Jangmyun/IoT_LoRa_PubSub_Rescue_System/detection_ml_v1/test/csv_result_001.csv

timestamp_ms | buoy_id | sonar_cm | accel_mag_ms2 | sonar_valid | sonar_timeout | label
1781516877224 | 2 | 60 | 11.0 | 1 | 0
1781516879137 | 1 | 56 | 11.5 | 1 | 0
1781516880315 | 2 | 63 | 10.9 | 1 | 0
1781516883416 | 2 | 31 | 10.9 | 1 | 0
1781516885319 | 1 | 36 | 11.6 | 1 | 0
1781516886483 | 2 | 24 | 11.0 | 1 | 0
1781516888399 | 1 | 32 | 11.7 | 1 | 0
1781516889541 | 2 | 20 | 11.0 | 1 | 0
1781516891519 | 1 | 89 | 11.6 | 1 | 0
1781516892589 | 2 | 20 | 10.9 | 1 | 0
1781516894554 | 1 | 86 | 11.6 | 1 | 0
1781516895645 | 2 | 20 | 11.0 | 1 | 0
1781516897707 | 1 | 83 | 11.7 | 1 | 0
1781516898731 | 2 | 21 | 10.9 | 1 | 0
1781516900847 | 1 | 84 | 11.6 | 1 | 0
1781516903912 | 1 | 255 | 11.6 | 1 | 0
1781516905035 | 2 | 20 | 11.0 | 1 | 0
1781516907014 | 1 | 23 | 11.6 | 1 | 0
1781516907936 | 2 | 20 | 11.1 | 1 | 0
1781516910063 | 1 | 23 | 11.5 | 1 | 0
1781516910989 | 2 | 20 | 11.0 | 1 | 0
1781516913123 | 1 | 22 | 11.6 | 1 | 0
1781516914052 | 2 | 20 | 11.0 | 1 | 0
1781516916176 | 1 | 22 | 11.6 | 1 | 0
1781516917108 | 2 | 20 | 11.0 | 1 | 0
1781516919230 | 1 | 22 | 11.6 | 1 | 0
1781516920525 | 2 | 20 | 11.0 | 1 | 0
1781516922313 | 1 | 22 | 11.6 | 1 | 0
1781516923672 | 2 | 20 | 11.0 | 1 | 0
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
