Jangmyun/IoT_LoRa_PubSub_Rescue_System/detection_ml_v1/test/csv_result_002.csv

timestamp_ms | buoy_id | sonar_cm | accel_mag_ms2 | sonar_valid | sonar_timeout | label
1781517057866 | 1 | 20 | 9.4 | 1 | 0
1781517060074 | 2 | 56 | 11.5 | 1 | 0
1781517061756 | 1 | 20 | 11.6 | 1 | 0
1781517063495 | 2 | 226 | 11.1 | 1 | 0
1781517065116 | 1 | 24 | 10.0 | 1 | 0
1781517066651 | 2 | 184 | 8.9 | 1 | 0
1781517068195 | 1 | 124 | 12.8 | 1 | 0
1781517069833 | 2 | 113 | 10.7 | 1 | 0
1781517071462 | 1 | 67 | 10.6 | 1 | 0
1781517073244 | 2 | 126 | 11.8 | 1 | 0
1781517074971 | 1 | 126 | 11.9 | 1 | 0
1781517076584 | 2 | 42 | 11.7 | 1 | 0
1781517078333 | 1 | 118 | 12.1 | 1 | 0
1781517080006 | 2 | 34 | 10.4 | 1 | 0
1781517081653 | 1 | 155 | 11.1 | 1 | 0
1781517083326 | 2 | 40 | 10.0 | 1 | 0
1781517085028 | 1 | 153 | 11.4 | 1 | 0
1781517086784 | 1 | 20 | 10.3 | 1 | 0
1781517088474 | 2 | 124 | 12.6 | 1 | 0
1781517090068 | 2 | 118 | 11.1 | 1 | 0
1781517091703 | 2 | 123 | 10.8 | 1 | 0
1781517093412 | 1 | 24 | 11.5 | 1 | 0
1781517095114 | 2 | 126 | 9.9 | 1 | 0
1781517096839 | 1 | 51 | 11.1 | 1 | 0
1781517098708 | 2 | 118 | 10.4 | 1 | 0
1781517100392 | 1 | 21 | 11.2 | 1 | 0
1781517102121 | 2 | 120 | 10.7 | 1 | 0
1781517103901 | 1 | 30 | 11.8 | 1 | 0
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
