Jangmyun/IoT_LoRa_PubSub_Rescue_System/detection_ml_v1/test/csv_result_004.csv

timestamp_ms | buoy_id | sonar_cm | accel_mag_ms2 | sonar_valid | sonar_timeout | label
1781517398385 | 1 | 20 | 11.2 | 1 | 0
1781517401382 | 1 | 30 | 11.3 | 1 | 0
1781517404432 | 1 | 122 | 11.1 | 1 | 0
1781517405460 | 2 | 56 | 14.3 | 1 | 0
1781517407532 | 1 | 158 | 10.6 | 1 | 0
1781517408594 | 2 | 150 | 13.1 | 1 | 0
1781517410610 | 1 | 119 | 13.4 | 1 | 0
1781517411764 | 2 | 22 | 9.6 | 1 | 0
1781517413760 | 1 | 33 | 12.6 | 1 | 0
1781517414895 | 2 | 40 | 12.8 | 1 | 0
1781517416864 | 1 | 122 | 10.9 | 1 | 0
1781517417976 | 2 | 26 | 13.4 | 1 | 0
1781517420018 | 1 | 69 | 13.1 | 1 | 0
1781517421124 | 2 | 20 | 11.7 | 1 | 0
1781517423066 | 1 | 45 | 12.4 | 1 | 0
1781517424259 | 2 | 28 | 10.7 | 1 | 0
1781517426156 | 1 | 109 | 11.8 | 1 | 0
1781517427333 | 2 | 28 | 11.6 | 1 | 0
1781517429255 | 1 | 73 | 13.8 | 1 | 0
1781517430457 | 2 | 40 | 14.4 | 1 | 0
1781517432333 | 1 | 90 | 12.2 | 1 | 0
1781517433551 | 2 | 255 | 6.7 | 1 | 0
1781517435431 | 1 | 255 | 10.8 | 1 | 0
1781517436634 | 2 | 64 | 7.3 | 1 | 0
1781517438497 | 1 | 20 | 11.0 | 1 | 0
1781517439916 | 2 | 58 | 12.6 | 1 | 0
1781517441631 | 1 | 69 | 12.2 | 1 | 0
1781517443204 | 2 | 48 | 9.3 | 1 | 0
1781517444713 | 1 | 49 | 12.2 | 1 | 0
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
