Jangmyun/IoT_LoRa_PubSub_Rescue_System/detection_ml_v1/tests/csv_result_002_idle.csv

timestamp_ms | buoy_id | sonar_cm | accel_mag_ms2 | sonar_valid | sonar_timeout | label
1781422332278 | 1 | 20 | 11.4 | 1 | 0 | CALM
1781422333188 | 2 | 20 | 10.8 | 1 | 0 | CALM
1781422335329 | 1 | 20 | 11.4 | 1 | 0 | CALM
1781422338386 | 1 | 20 | 11.3 | 1 | 0 | CALM
1781422339341 | 2 | 20 | 10.9 | 1 | 0 | CALM
1781422341434 | 1 | 20 | 11.5 | 1 | 0 | CALM
1781422342408 | 2 | 202 | 10.8 | 1 | 0 | CALM
1781422344488 | 1 | 20 | 11.4 | 1 | 0 | CALM
1781422345565 | 2 | 156 | 11.0 | 1 | 0 | CALM
1781422347544 | 1 | 20 | 11.5 | 1 | 0 | CALM
1781422348685 | 2 | 101 | 10.9 | 1 | 0 | CALM
1781422350637 | 1 | 20 | 11.4 | 1 | 0 | CALM
1781422351742 | 2 | 98 | 10.9 | 1 | 0 | CALM
1781422353717 | 1 | 20 | 11.3 | 1 | 0 | CALM
1781422354832 | 2 | 100 | 10.9 | 1 | 0 | CALM
1781422356818 | 1 | 20 | 11.4 | 1 | 0 | CALM
1781422357894 | 2 | 98 | 10.9 | 1 | 0 | CALM
1781422359879 | 1 | 20 | 11.5 | 1 | 0 | CALM
1781422360952 | 2 | 103 | 10.9 | 1 | 0 | CALM
1781422362941 | 1 | 20 | 11.3 | 1 | 0 | CALM
1781422364001 | 2 | 96 | 10.9 | 1 | 0 | CALM
1781422366019 | 1 | 20 | 11.3 | 1 | 0 | CALM
1781422367118 | 2 | 154 | 10.9 | 1 | 0 | CALM
1781422369116 | 1 | 20 | 11.4 | 1 | 0 | CALM
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
