Jangmyun/IoT_LoRa_PubSub_Rescue_System/detection_ml_v1/tests/csv_result_003_wave.csv

timestamp_ms | buoy_id | sonar_cm | accel_mag_ms2 | sonar_valid | sonar_timeout | label
1781422558638 | 2 | 56 | 11.4 | 1 | 0 | ENVIRONMENTAL_WAVE
1781422559076 | 1 | 20 | 10.4 | 1 | 0 | ENVIRONMENTAL_WAVE
1781422561774 | 2 | 52 | 9.5 | 1 | 0 | ENVIRONMENTAL_WAVE
1781422562097 | 1 | 20 | 9.3 | 1 | 0 | ENVIRONMENTAL_WAVE
1781422564882 | 2 | 48 | 12.0 | 1 | 0 | ENVIRONMENTAL_WAVE
1781422565151 | 1 | 20 | 11.0 | 1 | 0 | ENVIRONMENTAL_WAVE
1781422567960 | 2 | 49 | 12.5 | 1 | 0 | ENVIRONMENTAL_WAVE
1781422568243 | 1 | 20 | 12.2 | 1 | 0 | ENVIRONMENTAL_WAVE
1781422570959 | 2 | 44 | 12.0 | 1 | 0 | ENVIRONMENTAL_WAVE
1781422571305 | 1 | 20 | 10.7 | 1 | 0 | ENVIRONMENTAL_WAVE
1781422574062 | 2 | 46 | 10.6 | 1 | 0 | ENVIRONMENTAL_WAVE
1781422574392 | 1 | 20 | 10.7 | 1 | 0 | ENVIRONMENTAL_WAVE
1781422577137 | 2 | 123 | 11.7 | 1 | 0 | ENVIRONMENTAL_WAVE
1781422577457 | 1 | 20 | 10.7 | 1 | 0 | ENVIRONMENTAL_WAVE
1781422580285 | 2 | 33 | 10.0 | 1 | 0 | ENVIRONMENTAL_WAVE
1781422580510 | 1 | 20 | 11.2 | 1 | 0 | ENVIRONMENTAL_WAVE
1781422583378 | 2 | 27 | 12.6 | 1 | 0 | ENVIRONMENTAL_WAVE
1781422583594 | 1 | 20 | 9.9 | 1 | 0 | ENVIRONMENTAL_WAVE
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
