Jangmyun/IoT_LoRa_PubSub_Rescue_System/detection_ml_v1/artifacts/test_set_eval_v1/03_per_class_precision_recall_f1.png

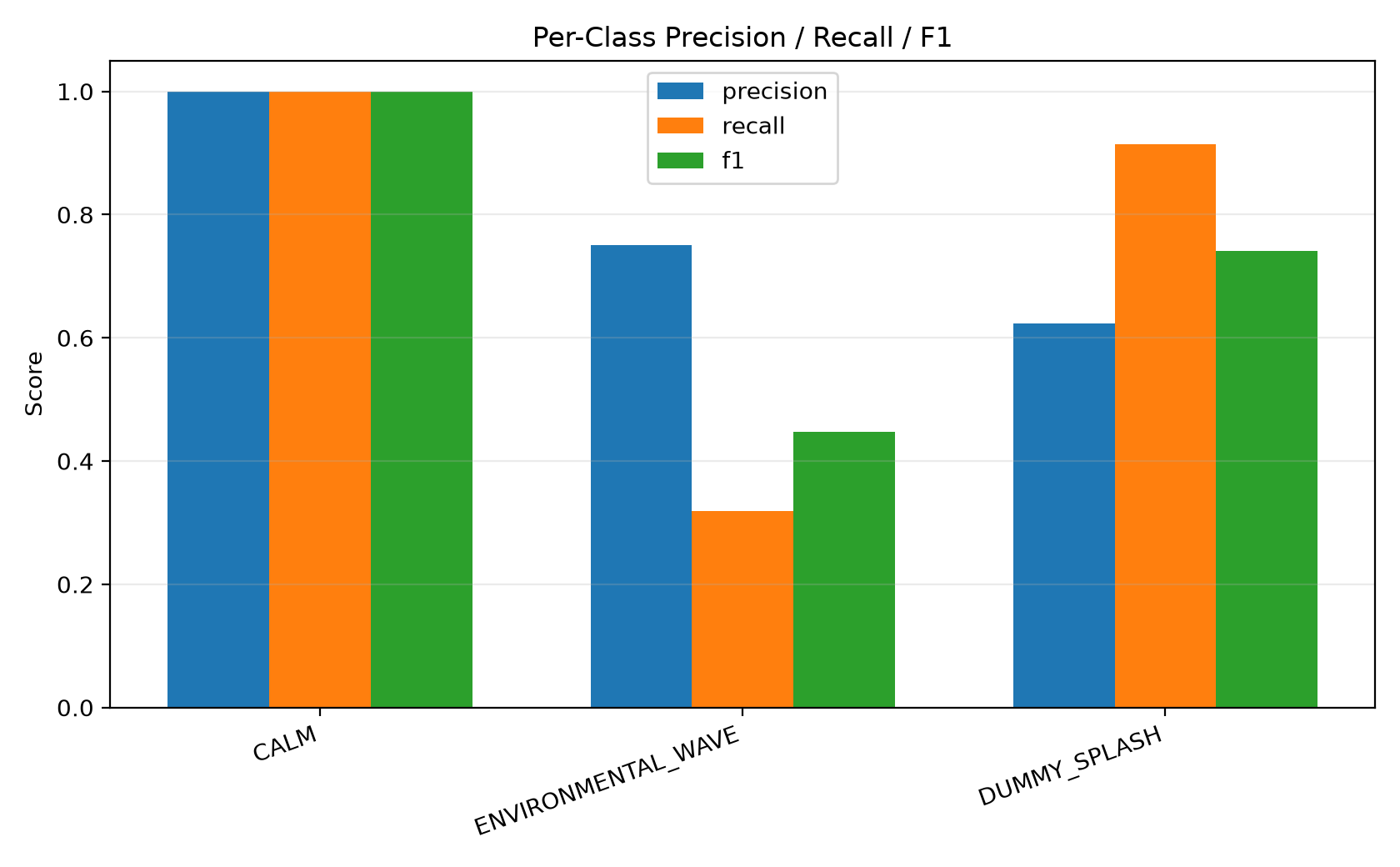
detection_ml_v1/artifacts/test_set_eval_v1/03_per_class_precision_recall_f1.png
