Jangmyun/IoT_LoRa_PubSub_Rescue_System/detection_ml_v1/artifacts/test_set_eval_v1/05_prediction_counts_by_source.png

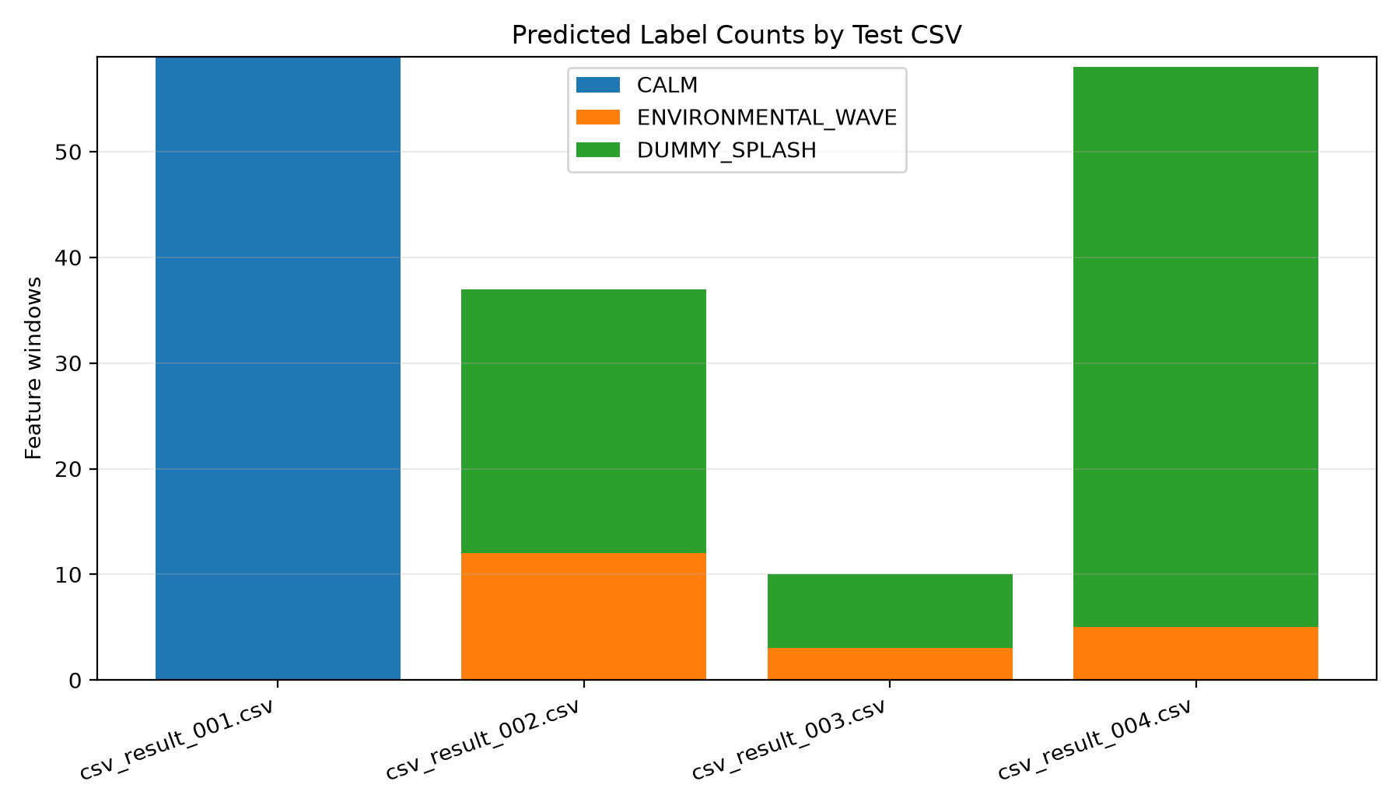
detection_ml_v1/artifacts/test_set_eval_v1/05_prediction_counts_by_source.png
