Jangmyun/IoT_LoRa_PubSub_Rescue_System/(commit log)

2026-06-09 add: arduino.json
2026-06-09 PlatformIO test용 프로젝트
2026-06-09 feat: lora packet format 및 relate method 정의
2026-06-09 feat: mock 기반 테스트용 세팅 추가 (ini)
2026-06-09 LoRaPubSub 테스트 코드
2026-06-09 native 테스트 시 유닛테스트 실행하도록 설정
2026-06-09 프로젝트 빌드 시 native까지 포함되는 문제 해결
2026-06-09 wokwi 시뮬레이션을 위해 esp32에 hc-sr04와 mpu-6050 센서 diagram 추가
2026-06-09 PRD 업데이트
2026-06-09 add: ISensor 순수 추상 인터페이스
    센서 플러그인 구조의 기반이 되는 ISensor 인터페이스 정의.
    begin / read / getValue / getPacked 4개 메서드를 강제하여
    다른 센서 구현체들이 공통 계약을 따르도록 한다.
2026-06-09 add: SonarSensor — HC-SR04 초음파 센서 드라이버
    pulseIn() 기반으로 TRIG/ECHO GPIO를 직접 제어.
    타임아웃 30ms(약 5m) 초과 시 read() false 반환.
    getPacked()는 0-255 cm 클램프 후 1바이트 반환 (LoRa payload용).
2026-06-09 add: ImuSensor — MPU-6050 가속도 센서 드라이버
    Adafruit MPU6050 라이브러리 기반. 3축 가속도의 크기(magnitude)를
    m/s²로 반환하며, getPacked()에서 ×10 후 0-255로 양자화.
    begin() 실패 시 false 반환하여 센서 없는 환경에서도 매니저가 동작 가능.
2026-06-09 add: SensorManager — ISensor 배열 관리 및 LoRa 발행
    attach()로 ISensor* 최대 4개를 동적으로 등록.
    readAll() 후 publishRaw()가 등록 순서대로 getPacked() 값을
    TOPIC_SENSOR_RAW payload로 조립하여 LoRaPubSub으로 발행.
    새 센서 추가 시 ISensor 구현 후 attach() 한 줄로 확장 가능.
2026-06-09 chore: sensor default attr 변경
2026-06-09 dependency 추가: mpu-6050
2026-06-09 sensor example main.cpp
2026-06-09 simulation 속도 조절
2026-06-10 remove: arduino ide based project deleted
2026-06-10 fix: directory name fixed
    [main.cpp]
2026-06-10 구 PlatformIO 폴더 제거
2026-06-10 feat: RPi4 를 위한 LoRa Gateway Server
2026-06-10 fix: wokwi status sensor send
2026-06-10 feat: RPI4 gateway-server 구조 및 연동 구현
    - gateway/lib/packet.py: LoRaPubSub.h 패킷 구조 Python 매핑 (LoRaPublish, LoRaAck, CRC-8)
    - gateway/serial_reader.py: /dev/ttyACM0 시리얼 읽기 및 패킷 파싱 (preamble 스캔, 재연결)
    - gateway/broker.py: 토픽 기반 pub/sub 디스패처 (카테고리 와일드카드, subscribe_all)
    - gateway/main.py: serial_reader + broker 연결, httpx로 server에 패킷 포워딩
    - server/main.py: topic 기반 status 판정 수정 (ALERT=0x10, CLEAR=0x11, 나머지 유지)
    - server/static/index.html: WebSocket 실시간 대시보드 (부표 카드, 경보 배너, 이벤트 로그)
    - run.sh: server/gateway 동시 기동 및 일괄 종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
    [broker.py, main.py, serial_reader.py]
2026-06-10 gateway server setup 및 run 스크립트
2026-06-10 server 실행스크립트 Mock 데이터 설정값 기본 0 (mock 없음) 으로 변경
2026-06-10 lora syncword 동일 값으로 고정
2026-06-10 lora 펌웨어와 python 소스의 crc8 계산 방법을 통일
2026-06-10 run.sh : 커맨드라인 option 추가 (로그 레벨 지정)
2026-06-10 lora 수신 시 ascii byte logging
2026-06-10 0xAB preamble와 CRC 올바른 위치를 가지도록 수정
2026-06-10 빌드, 업로드 진입점 하나로 제한
2026-06-10 순수 binary 만 serial 로 내보내도록 변경
2026-06-10 log level 분리
2026-06-10 fixed length 패킷으로 crc 정렬 로직 제거
    [gateway_main.cpp]
2026-06-10 파이썬 게이트웨이에서 rssi, snr 읽는 로직 추가
2026-06-10 crc 관련 유닛 테스트 추가
2026-06-10 가변 사이즈 패킷 CRC 처리 로직 재추가
2026-06-10 가변 길이 패킷 조립 로직 추가
2026-06-10 relay 송수신 로직 변경 (relay 시 src node id를 변경하지 않음)
2026-06-10 node id 변경 쉽게 변경
2026-06-11 _mpu.begin() 호출 시 AD0 핀 실패 시 0x69 로 재시도 로직 추가
2026-06-13 Wokwi Diagram에 센서 5V 이므로 변압 저항 추가
2026-06-14 add: ml
    [csv_result_002_idle.csv, csv_result_003_wave.csv, csv_result_004_victim.csv]
2026-06-15 ML 모델 배포 경로 추가
    [metrics.csv]
2026-06-15 sensor 인식 실패 시 relay 전용 노드로 강등하는 로직 반영
2026-06-15 PRD.md 업데이트
2026-06-15 add: ml + rule based
    [csv_result_005.csv, csv_result_006.csv, csv_result_007.csv, metrics.csv]
2026-06-15 add: 대시보드에 relay-only 강등 상태 표시
    heartbeat status 바이트 bit0(HB_STATUS_DEGRADED)를 relay_only 필드로
    디코드하고, 후속 패킷에서도 sticky하게 유지한다. 부표 카드 헤더에
    RELAY ONLY 노랑 뱃지와 노랑 외곽선을 추가해 시각적으로 구분한다.
2026-06-15 add: QoS-1 비동기 outbox 큐 구현 (LoRaPubSub)
    publish()를 non-blocking으로 전환하고 OutboxEntry 슬롯에 enqueue.
    tick()마다 _processOutbox()로 첫 전송·재전송·만료 드롭 처리,
    ACK 수신 시 _ackOutbox()로 해당 슬롯 해제.
2026-06-15 fix: publish() 반환값 로그 메시지를 non-blocking 시맨틱에 맞게 수정
    ok → enqueued, "ACK OK"/"FAILED" → "enqueued"/"outbox full"
    [main.cpp]
2026-06-15 fix: Adafruit_MPU6050 mock begin()에 default addr 파라미터 추가
    실제 라이브러리 시그니처(begin(uint8_t addr = 0x68))와 맞춤
2026-06-15 test: outbox QoS-1 시나리오 테스트 추가 (T14~T19)
    enqueue 반환값, outbox 가득 참, 첫 tick 전송, ACK 해제,
    재전송 후 드롭, 잘못된 msg_id ACK 무시 케이스 커버
2026-06-15 add: 게이트웨이 CRC 검증 통과 시 LoRa ACK 즉시 전송
    CRC pass = LoRa hop 전달 보장으로 보고, _sendAck()로 LoRaAck 브로드캐스트.
    부표 outbox가 ACK를 수신해 슬롯을 해제할 수 있도록 함.
2026-06-15 docs: PRD 현황 업데이트 (2026-06-15)
    QoS-1 non-blocking outbox 큐, 게이트웨이 ACK 전송,
    유닛테스트 19개 반영. ACK 릴레이 미지원 제약 명시.
2026-06-15 fix: relay_only 해제 로직 수정 — 재부팅 후 정상 노드 복구 반영
    heartbeat HB_STATUS_DEGRADED 비트 클리어 시 즉시 해제,
    SENSOR_RAW·ALERT·ALERT_CLEAR 수신 시도 해제 (강등 노드는 이 토픽을 보내지 않음).
    sticky OR 로직 제거. 테스트 3개 추가(정상 heartbeat·SENSOR_RAW·unknown topic).
2026-06-15 fix: ImuSensor::begin() I2C 안정화 전 실패 오인 방지
    부팅 직후 I2C 버스가 미안정 상태에서 _mpu.begin()이 실패해
    즉시 relay-only latch로 빠지는 문제 수정.
    100ms 간격 최대 3회 재시도 후 최종 실패 시에만 false 반환.
2026-06-15 fix: 센서 begin() 실패 시 즉시 relay-only latch 제거, grace period 재시도로 전환
    setup()의 즉시 latch 제거. loop() 상단에서 SENSOR_GRACE_PERIOD_MS(10s) 동안
    500ms마다 retryFailed()로 미준비 센서 재시도. 만료 후에도 실패 시 relay-only latch.
    SensorManager에 retryFailed() 메서드 추가.
    [main.cpp]
2026-06-15 remove: sensor 실패 기반 relay-only 강등 로직 전면 제거
    relay_only_mode, enterRelayOnlyMode, sonar/imu_fail_streak,
    SENSOR_FAULT_THRESHOLD, SENSOR_GRACE_PERIOD_MS, grace period 재시도 블록,
    HB_STATUS_DEGRADED heartbeat 표시, SensorManager::retryFailed() 모두 제거.
    sonar read() false는 정상 측정 결과(범위 밖)이므로 장애 판단 기준으로 부적합.
2026-06-15 feat: relay_only 판단을 서버 사이드 SENSOR_RAW 수신 시각 기반으로 전환
    펌웨어 HB_STATUS_DEGRADED 비트 제거에 대응.
    build_buoy_state()에서 last_sensor_raw_at 추적,
    compute_relay_only()로 timeout(기본 30s) 초과 여부를 판단.
    /api/buoys에서 현재 시각 기준 재계산으로 페이로드 최신성 보장.
    SENSOR_RAW_TIMEOUT_S 환경변수로 임계값 조정 가능.
2026-06-15 테스트 평가 그래프 추가
